Klok100/Automatic-Guitar-Tuner/ECE 445 Linear Regulator Analysis.pdf

3.3 Voltage regulator - LM2937-3.3

Part | Worst Case Current Draw @ 3.3 V | Comment
Processor | 140 mA | Total output current sunk by all I/O and Control Pins
LED (2) | 15 mA (30 mA total) | Assuming 100% on rate, based on resistor and LED voltage drop values
Total | 170 mA

LP2950CZ

Variable | Value | Comment
max(Ti) | 125 C | Maximum operating junction temperature
iout | 170 mA | Maximum current draw of 3.3 V components
vin | 9.6 V | Maximum voltage of a 9 V battery
vout | 3.3 V | Operating voltage of components
Θ ja | 65 C/W | Thermal resistance of junction to ambient per datasheet
Ta | 38 C | Hot day

T

j = i
out

(v

in − v
out

)(Θ) + T
a

≈ 108 C < max(T
i

)

5V Voltage regulator μA7805

Part | Worst Case Current Draw @ 5 V | Comment
L298N H Bridge (3) | 70 mA (210 mA total) | Max assuming: Ven = H; Vi = H; IL= 0
GA12-N20 Motors (6) | 30 mA (180 mA total) | Current consumed under load at 500 rpm
Total | 390 mA

μA7805

Variable | Value | Comment
max(Ti) | 150 C | Maximum operating junction temperature
iout | 390 mA | Max current draw of 5 V components
vin | 9.6 V | Maximum voltage of 9 V battery
vout | 5 V | Operating voltage of components
Θ ja | 19 C/W | Thermal resistance of junction to ambient per datasheet
Ta | 38 C | Hot Day

T

j = i
out

(v

in − v
out

)(Θ
jc

) + T
a

≈ 72 ℃ < max(T
i

)
