Klok100/Automatic-Guitar-Tuner/ECE 445 Senior-Design-Parts.md

# Senior Design Parts
## Power Subsystem:
#### Battery: 9V 
#### 3.3 Voltage Regulator: ~~AP2112K-3.3TRG1 (Electronics Service Shop)~~
LM2937-3.3 ([Digikey](https://www.digikey.com/en/products/detail/texas-instruments/LM2937ET-3-3-NOPB/363870)) ([Datasheet](https://rocelec.widen.net/view/pdf/oggg0ilb2c/NATLS20760-1.pdf?t.download=true&u=5oefqw])) TO-220 package  
#### 5 Voltage Regulator: ~~TPS7A2050PDBVR (Electronics Service Shop)~~
$\mu \text{A7805}$  ([Digikey](https://www.digikey.com/en/products/detail/texas-instruments/UA7805CKCS/521612))(~~[Mouser](https://www.mouser.com/ProductDetail/Texas-Instruments/UA7805CKCS?qs=IEl3ej0IqwDTl9fhEpiFdQ%3D%3D)~~) ([Datasheet](https://www.ti.com/lit/ds/symlink/ua78.pdf?ts=1740651676563&ref_url=https%253A%252F%252Fwww.google.com%252F)) TO-220 package (KCS)
## Motor Subsystem:
#### H-Bridge: L298N (Self-Service Inventory) ([Datasheet](https://www.st.com/resource/en/datasheet/l298.pdf)) (C11 D20)
#### Motors: GA12-N20 ([Amazon](https://www.amazon.com/dp/B07FYBQ7Z4?ref=ppx_yo2ov_dt_b_fed_asin_title))

## Processing Subsystem:
#### Microcontroller: STM32H7B0RBT6 ([Digikey](https://www.digikey.com/en/products/detail/stmicroelectronics/STM32H7B0RBT6/11591017)) ([Datasheet](https://www.st.com/resource/en/datasheet/stm32h7b0rb.pdf))

## Vibration Subsystem:
#### Piezo Disc Transducer: TXJ-055-US ([Amazon](https://www.amazon.com/dp/B077YJ3H6R?ref=ppx_yo2ov_dt_b_fed_asin_title))
#### Signal Amplifier: LM386N-1 ([Mouser](https://www.mouser.com/ProductDetail/Texas-Instruments/LM386N-1-NOPB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)) ([Datasheet](https://www.ti.com/lit/ds/symlink/lm386.pdf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)) (C12 D19)
#### Zener Diode: 1N4733A ([Digikey](https://www.digikey.com/en/products/detail/onsemi/1N4733A/977210)) ([Datasheet](https://rocelec.widen.net/view/pdf/7qfz7dzkx8/ONSM-S-A0003585147-1.pdf?t.download=true&u=5oefqw))
