Klok100/Automatic-Guitar-Tuner/3D_print/motor-dowel.stl

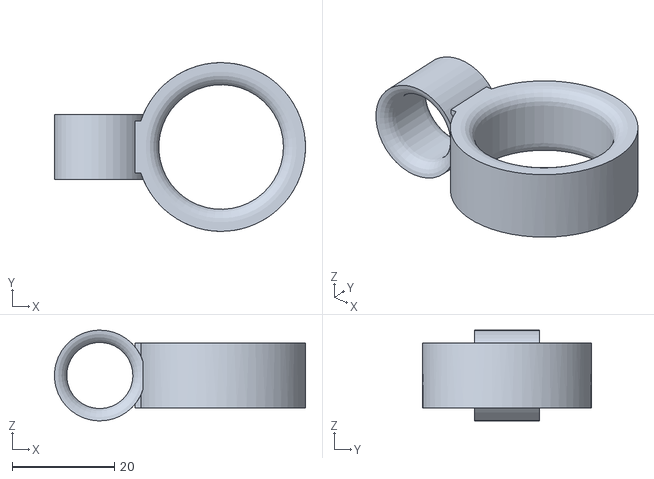
[picture p5: CAD file, 2025-05-09]
3D_print/motor-dowel.stl
49.1 x 33.0 x 17.8
