Klok100/Automatic-Guitar-Tuner/3D_print/PCB_mount.3mf

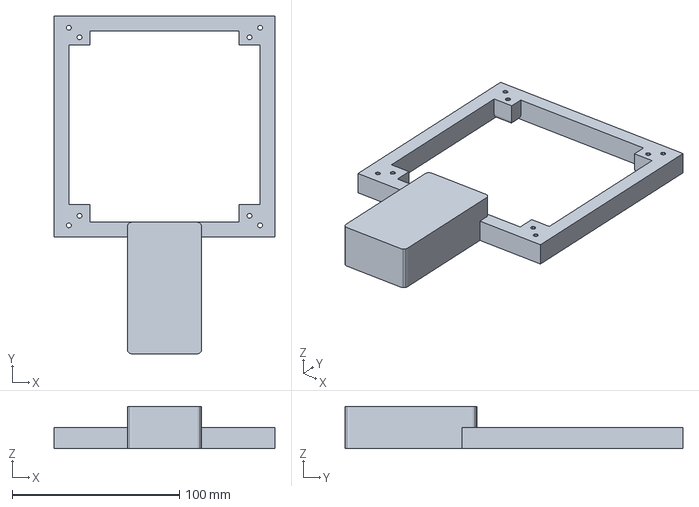
[picture p6: CAD file, 2025-05-09]
3D_print/PCB_mount.3mf
132.1 x 201.9 x 25.4 mm
