Klok100/Automatic-Guitar-Tuner/3D_print/plug.3mf

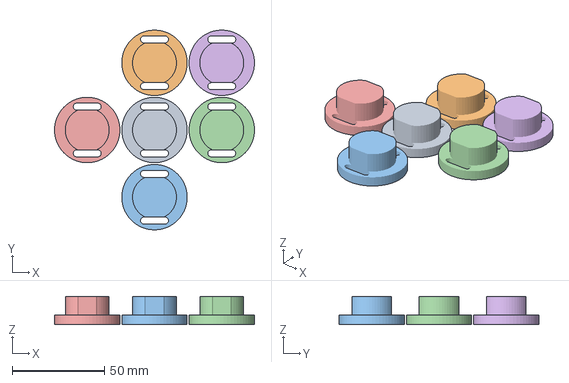
[picture p7: CAD file, 2025-05-09]
3D_print/plug.3mf
108.7 x 108.5 x 15.2 mm
plug.stl x 6
