Klok100/Automatic-Guitar-Tuner/3D_print/dowel-dowel.3mf

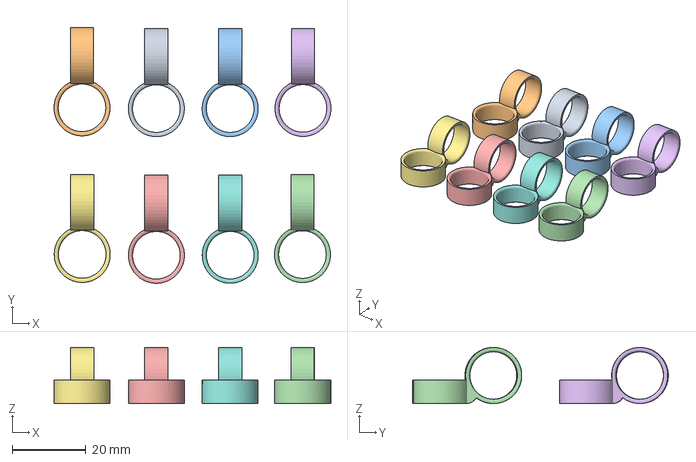
[picture p8: CAD file, 2025-05-09]
3D_print/dowel-dowel.3mf
75.3 x 69.5 x 15.2 mm
dowel-dowel.stl x 8
