Klok100/Automatic-Guitar-Tuner/3D_print/motor-tuningpeg-worm.stl

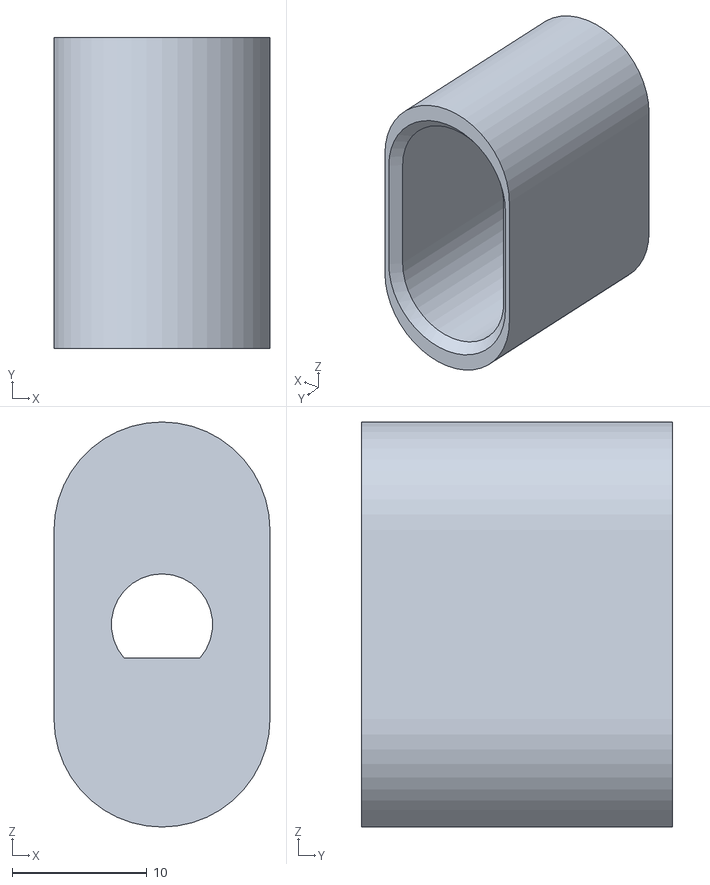
[picture p9: CAD file, 2025-05-09]
3D_print/motor-tuningpeg-worm.stl
16.0 x 23.0 x 30.0
