Klok100/Automatic-Guitar-Tuner/3D_print/magnet_mount_short.stl

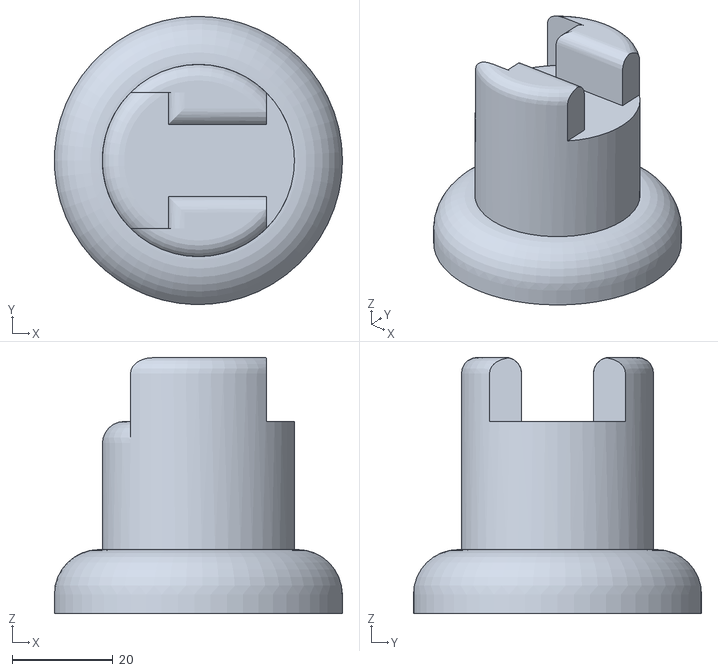
[picture p10: CAD file, 2025-04-02]
3D_print/magnet_mount_short.stl
57.1 x 57.1 x 50.8
