Klok100/Automatic-Guitar-Tuner/3D_print/magnet_mount.stl

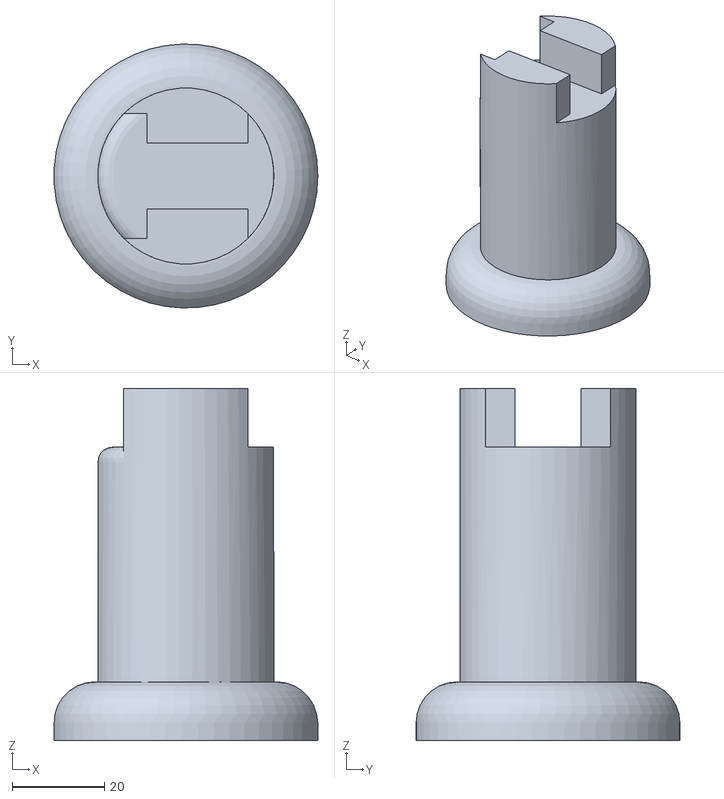
[picture p11: CAD file, 2025-04-02]
3D_print/magnet_mount.stl
57.1 x 57.1 x 76.2
