Klok100/Automatic-Guitar-Tuner/3D_print/motor-tuningpeg-mini.stl

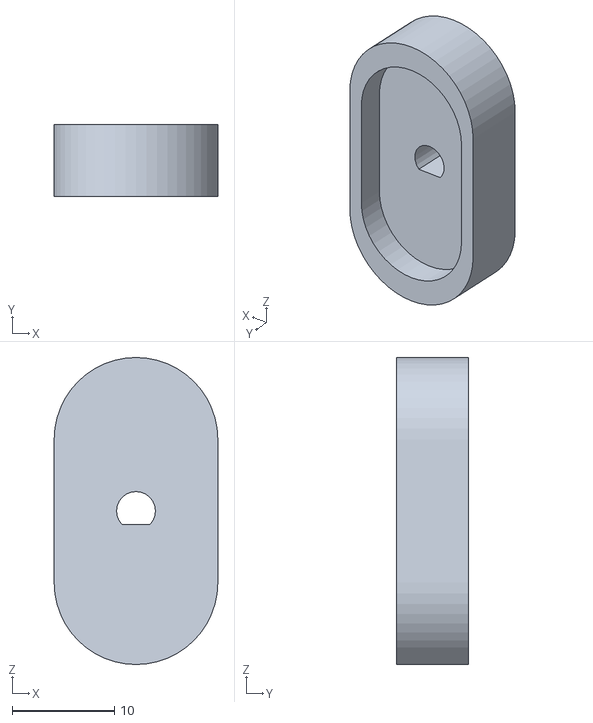
[picture p12: CAD file, 2025-03-06]
3D_print/motor-tuningpeg-mini.stl
16.0 x 7.00 x 30.0
