Klok100/Automatic-Guitar-Tuner/3D_print/N20shaft_sizing.stl

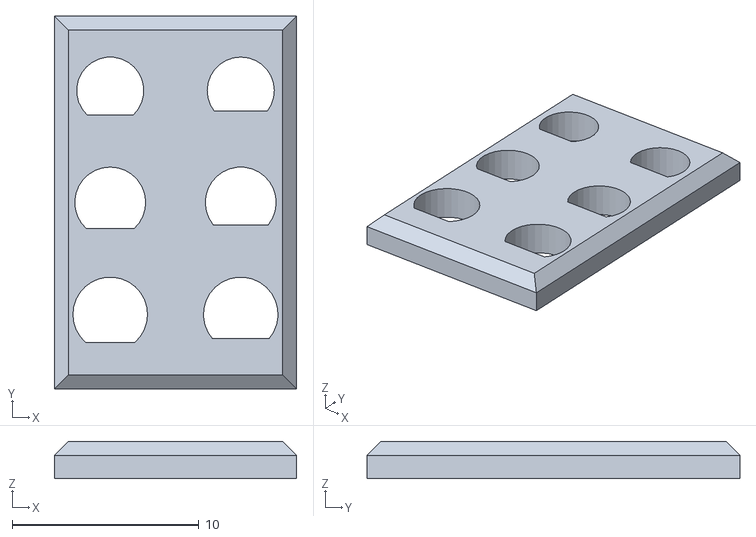
[picture p13: CAD file, 2025-03-06]
3D_print/N20shaft_sizing.stl
13.0 x 20.0 x 2.00
