Klok100/Automatic-Guitar-Tuner/(list of files, cad)

Other CAD files:
3D_print/PCB_mount.gcode.3mf
3D_print/plug.gcode.3mf
3D_print/dowel-dowel.gcode.3mf
3D_print/dowel-parts.gcode.3mf
3D_print/motor-tuningpeg.stl
3D_print/Battery.ipt
3D_print/Full_Model.iam
3D_print/Guitar.ipt
3D_print/N20shaft_sizing.ipt
3D_print/OldVersions/Battery.0001.ipt
3D_print/OldVersions/Full_Model.0013.iam
3D_print/OldVersions/Guitar.0003.ipt
3D_print/OldVersions/N20shaft_sizing.0002.ipt
3D_print/OldVersions/PCB.0003.ipt
3D_print/OldVersions/PCB_mount.0005.ipt
3D_print/OldVersions/dowel-dowel.0002.ipt
3D_print/OldVersions/half_inch_dowel_5inch.0001.ipt
3D_print/OldVersions/magnet_mount.0003.ipt
3D_print/OldVersions/motor-dowel.0002.ipt
3D_print/OldVersions/motor-tuningpeg-mini.0001.ipt
3D_print/OldVersions/motor-tuningpeg.0008.ipt
3D_print/OldVersions/plug.0001.ipt
3D_print/OldVersions/tuningpeg.0001.ipt
3D_print/PCB.ipt
3D_print/PCB_mount.ipt
3D_print/PCB_mount.stl
3D_print/dowel-dowel.ipt
3D_print/dowel-dowel.stl
3D_print/half_inch_dowel_10inch.ipt
3D_print/half_inch_dowel_5inch.ipt
3D_print/magnet_mount.ipt
3D_print/motor-dowel.ipt
3D_print/motor-tuningpeg-mini.ipt
3D_print/motor-tuningpeg.ipt
3D_print/motor.ipt
3D_print/plug.ipt
3D_print/plug.stl
3D_print/tuningpeg.ipt
