Klok100/Automatic-Guitar-Tuner/Senior_Design_PCB_ethanl7_nrkim2/Senior_Design_PCB_ethanl7_nrkim2.kicad_pcb

## KiCad design Senior_Design_PCB_ethanl7_nrkim2/Senior_Design_PCB_ethanl7_nrkim2.kicad_pcb (2025-05-09)

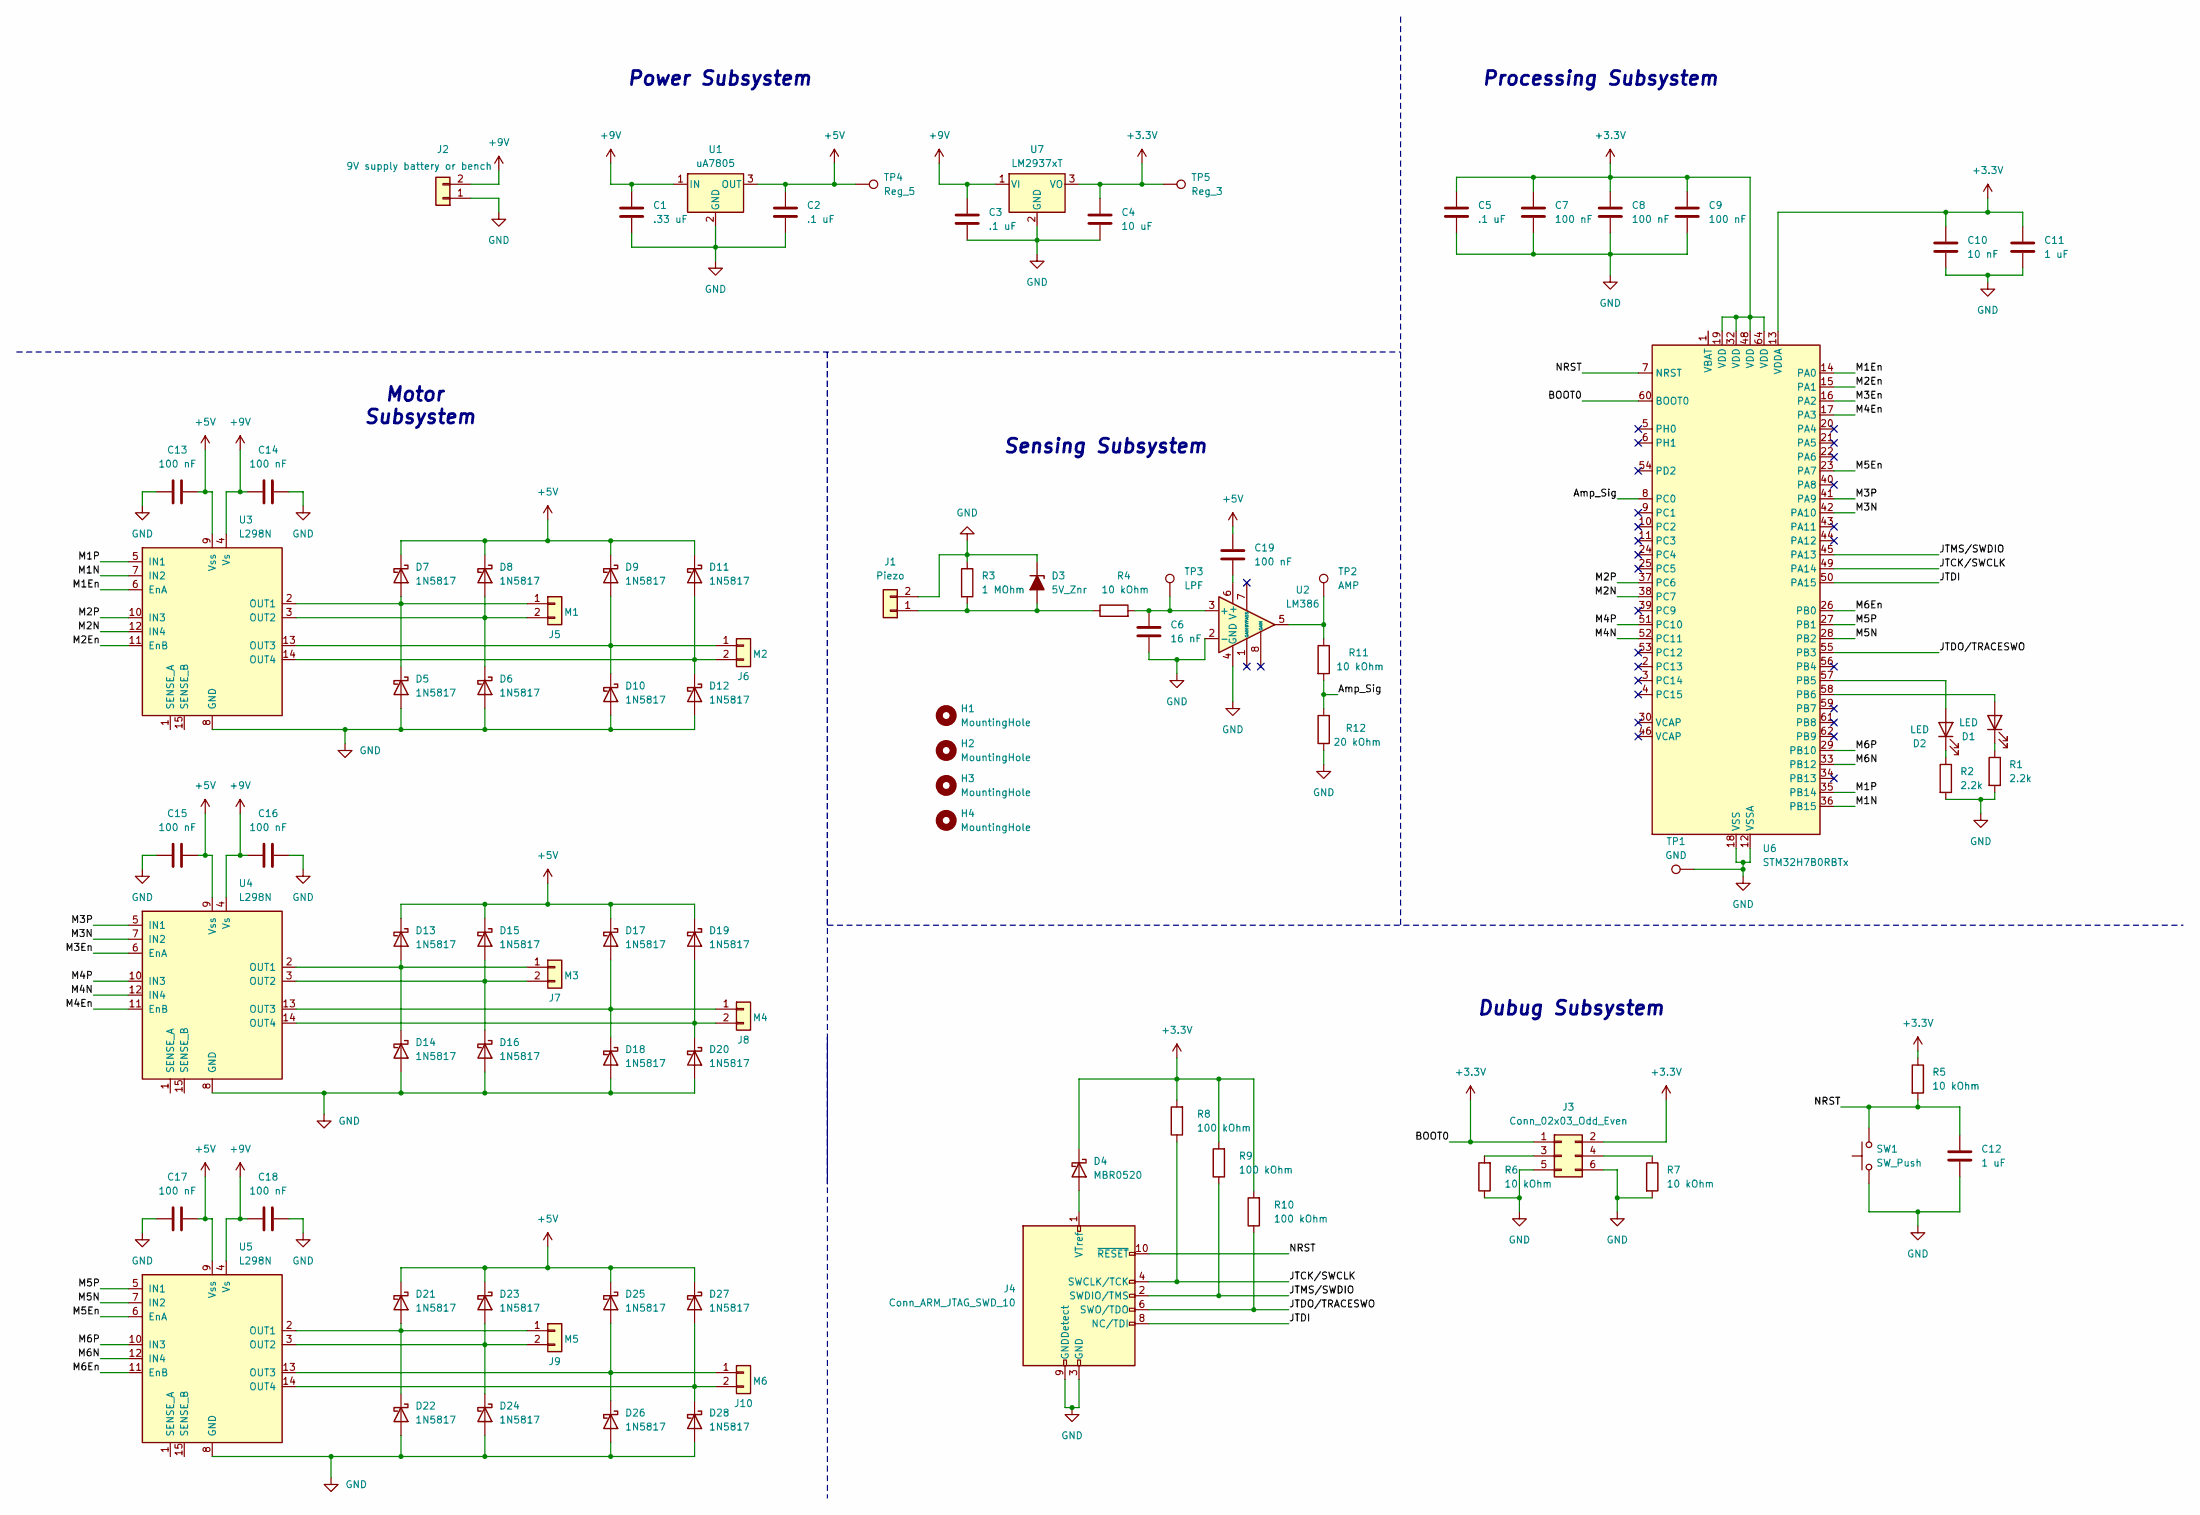
[picture p14: schematic Senior_Design_PCB_ethanl7_nrkim2.kicad_sch, Automatic Guitar Tuner]

Parts:
C1: .33 uF; C_0805_2012Metric_Pad1.18x1.45mm_HandSolder
C2, C3, C5: .1 uF; C_0805_2012Metric_Pad1.18x1.45mm_HandSolder
C4: 10 uF; C_0805_2012Metric_Pad1.18x1.45mm_HandSolder
C6: 16 nF; C_0805_2012Metric_Pad1.18x1.45mm_HandSolder
C7, C8, C9, C13, C14, C15, C16, C17, C18, C19: 100 nF; C_0805_2012Metric_Pad1.18x1.45mm_HandSolder
C10: 10 nF; C_0805_2012Metric_Pad1.18x1.45mm_HandSolder
C11, C12: 1 uF; C_0805_2012Metric_Pad1.18x1.45mm_HandSolder
D1, D2: LED; Molex_KK-254_AE-6410-02A_1x02_P2.54mm_Vertical
D3: 5V_Znr; D_DO-41_SOD81_P10.16mm_Horizontal
D4: MBR0520; D_SOD-123
D5, D6, D7, D8, D9, D10, D11, D12, D13, D14, D15, D16, D17, D18, D19, D20, D21, D22, D23, D24, D25, D26, D27, D28: 1N5817; D_DO-41_SOD81_P10.16mm_Horizontal
H1, H2, H3, H4: MountingHole; MountingHole_3.2mm_M3
J1: Piezo; Molex_KK-254_AE-6410-02A_1x02_P2.54mm_Vertical
J2: 9V supply battery or bench; Molex_KK-254_AE-6410-02A_1x02_P2.54mm_Vertical
J3: Conn_02x03_Odd_Even; PinSocket_2x03_P2.54mm_Vertical
J4: Conn_ARM_JTAG_SWD_10; IDC-Header_2x05_P2.54mm_Vertical
J5: M1; Molex_KK-254_AE-6410-02A_1x02_P2.54mm_Vertical
J6: M2; Molex_KK-254_AE-6410-02A_1x02_P2.54mm_Vertical
J7: M3; Molex_KK-254_AE-6410-02A_1x02_P2.54mm_Vertical
J8: M4; Molex_KK-254_AE-6410-02A_1x02_P2.54mm_Vertical
J9: M5; Molex_KK-254_AE-6410-02A_1x02_P2.54mm_Vertical
J10: M6; Molex_KK-254_AE-6410-02A_1x02_P2.54mm_Vertical
R1, R2: 2.2k; R_0805_2012Metric_Pad1.20x1.40mm_HandSolder
R3: 1 MOhm; R_0805_2012Metric_Pad1.20x1.40mm_HandSolder
R4, R5, R6, R7, R11: 10 kOhm; R_0805_2012Metric_Pad1.20x1.40mm_HandSolder
R8, R9, R10: 100 kOhm; R_0805_2012Metric_Pad1.20x1.40mm_HandSolder
R12: 20 kOhm; R_0805_2012Metric_Pad1.20x1.40mm_HandSolder
SW1: SW_Push; SW_SPST_B3S-1000
TP1: GND; TestPoint_Pad_D1.5mm
TP2: AMP; TestPoint_Pad_D1.5mm
TP3: LPF; TestPoint_Pad_D1.5mm
TP4: Reg_5; TestPoint_Pad_D1.5mm
TP5: Reg_3; TestPoint_Pad_D1.5mm
U1: uA7805; TO-220-3_Vertical
U2: LM386; DIP-8_W7.62mm
U3, U4, U5: L298N; TO-220-15_P2.54x2.54mm_StaggerOdd_Lead4.58mm_Vertical
U6: STM32H7B0RBTx; LQFP-64_10x10mm_P0.5mm
U7: LM2937xT; TO-220-3_Vertical

Connections:
+3.3V: C4.1, C5.1, C7.1, C8.1, C9.1, C10.1, C11.1, D4.1 (K), J3.1, J3.2, R5.1, R8.2, R9.2, R10.2, TP5.1, U6.13 (VDDA), U6.19 (VDD), U6.32 (VDD), U6.48 (VDD), U6.60 (BOOT0), U6.64 (VDD), U7.3 (VO)
+5V: C2.1, C13.2, C15.2, C17.2, C19.2, D7.1 (K), D8.1 (K), D9.1 (K), D11.1 (K), D13.1 (K), D15.1 (K), D17.1 (K), D19.1 (K), D21.1 (K), D23.1 (K), D25.1 (K), D27.1 (K), TP4.1, U1.3 (OUT), U3.9 (Vss), U4.9 (Vss), U5.9 (Vss)
+9V: C1.1, C3.1, C14.1, C16.1, C18.1, J2.2, U1.1 (IN), U3.4 (Vs), U4.4 (Vs), U5.4 (Vs), U7.1 (VI)
/Amp_Sig: R11.2, R12.2, U6.8 (PC0)
/JTCK/SWCLK: J4.4 (SWCLK/TCK), R8.1, U6.49 (PA14)
/JTDI: J4.8 (NC/TDI), U6.50 (PA15)
/JTDO/TRACESWO: J4.6 (SWO/TDO), R10.1, U6.55 (PB3)
/JTMS/SWDIO: J4.2 (SWDIO/TMS), R9.1, U6.45 (PA13)
/M1En: U3.6 (EnA), U6.14 (PA0)
/M1N: U3.7 (IN2), U6.36 (PB15)
/M1P: U3.5 (IN1), U6.35 (PB14)
/M2En: U3.11 (EnB), U6.15 (PA1)
/M2N: U3.12 (IN4), U6.38 (PC7)
/M2P: U3.10 (IN3), U6.37 (PC6)
/M3En: U4.6 (EnA), U6.16 (PA2)
/M3N: U4.7 (IN2), U6.42 (PA10)
/M3P: U4.5 (IN1), U6.41 (PA9)
/M4En: U4.11 (EnB), U6.17 (PA3)
/M4N: U4.12 (IN4), U6.52 (PC11)
/M4P: U4.10 (IN3), U6.51 (PC10)
/M5En: U5.6 (EnA), U6.23 (PA7)
/M5N: U5.7 (IN2), U6.28 (PB2)
/M5P: U5.5 (IN1), U6.27 (PB1)
/M6En: U5.11 (EnB), U6.26 (PB0)
/M6N: U5.12 (IN4), U6.33 (PB12)
/M6P: U5.10 (IN3), U6.29 (PB10)
/NRST: C12.1, J4.10 (~RESET), R5.2, SW1.2, U6.7 (NRST)
GND: C1.2, C2.2, C3.2, C4.2, C5.2, C6.1, C7.2, C8.2, C9.2, C10.2, C11.2, C12.2, C13.1, C14.2, C15.1, C16.2, C17.1, C18.2, D3.1 (K), D5.2 (A), D6.2 (A), D10.2 (A), D12.2 (A), D14.2 (A), D16.2 (A), D18.2 (A), D20.2 (A), D22.2 (A), D24.2 (A), D26.2 (A), D28.2 (A), J1.2, J2.1, J3.5, J3.6, J4.3 (GND), J4.5 (GND), J4.9 (GNDDetect), R1.2, R2.2, R3.1, R6.1, R7.2, R12.1, SW1.1, TP1.1, U1.2 (GND), U2.2 (-), U2.4 (GND), U3.8 (GND), U4.8 (GND), U5.8 (GND), U6.12 (VSSA), U6.18 (VSS), U6.31 (VSS), U6.47 (VSS), U6.63 (VSS), U7.2 (GND)
unnamed: D1.2 (A), U6.58 (PB6)
unnamed: D1.1 (K), R1.1
unnamed: D2.2 (A), U6.57 (PB5)
unnamed: D2.1 (K), R2.1
unnamed: D3.2 (A), J1.1, R3.2, R4.1
unnamed: D4.2 (A), J4.1 (VTref)
unnamed: D5.1 (K), D7.2 (A), J5.1, U3.2 (OUT1)
unnamed: D6.1 (K), D8.2 (A), J5.2, U3.3 (OUT2)
unnamed: D9.2 (A), D10.1 (K), J6.1, U3.13 (OUT3)
unnamed: D11.2 (A), D12.1 (K), J6.2, U3.14 (OUT4)
unnamed: D13.2 (A), D14.1 (K), J7.1, U4.2 (OUT1)
unnamed: D15.2 (A), D16.1 (K), J7.2, U4.3 (OUT2)
unnamed: D17.2 (A), D18.1 (K), J8.1, U4.13 (OUT3)
unnamed: D19.2 (A), D20.1 (K), J8.2, U4.14 (OUT4)
unnamed: D21.2 (A), D22.1 (K), J9.1, U5.2 (OUT1)
unnamed: D23.2 (A), D24.1 (K), J9.2, U5.3 (OUT2)
unnamed: D25.2 (A), D26.1 (K), J10.1, U5.13 (OUT3)
unnamed: D27.2 (A), D28.1 (K), J10.2, U5.14 (OUT4)
unnamed: J3.3, R6.2
unnamed: J3.4, R7.1
unnamed: R11.1, TP2.1, U2.5
unnamed: C6.2, R4.2, TP3.1, U2.3 (+)
unnamed: C19.1, U2.6 (V+)

Notes on the sheet:
Power Subsystem
Processing Subsystem
Sensing Subsystem
Dubug Subsystem
Motor Subsystem

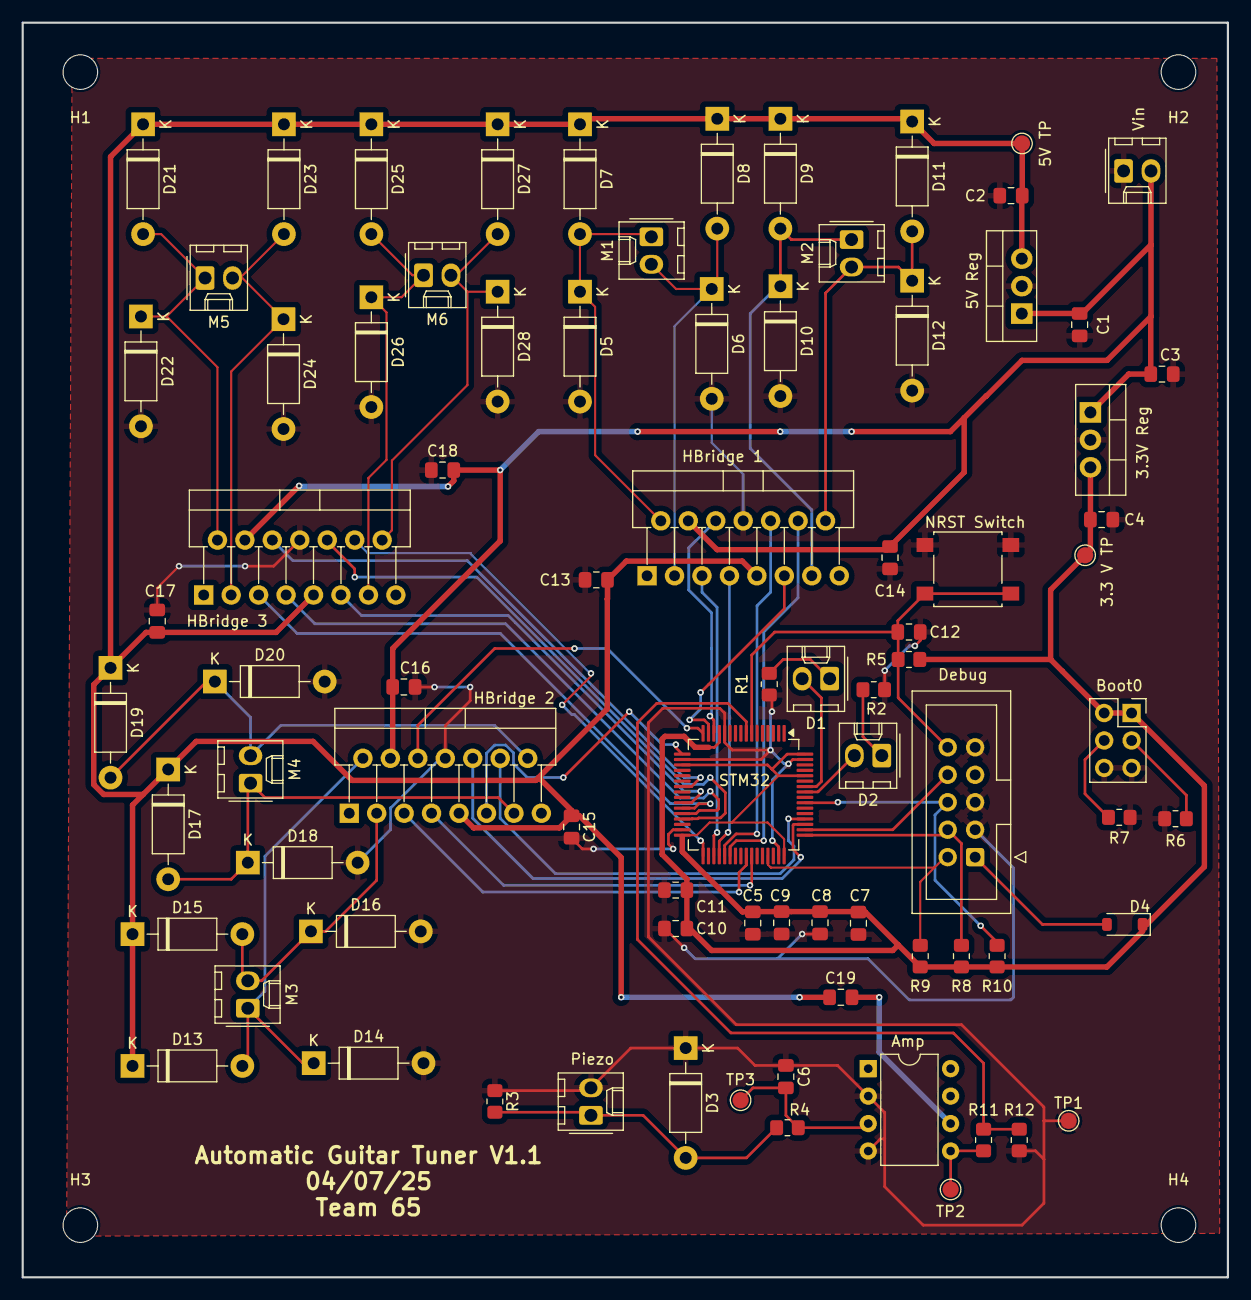
[picture p15: board Senior_Design_PCB_ethanl7_nrkim2.kicad_pcb from above]

Board: 2 copper layers, 111.5 x 116.1 mm, 86 parts (0 on the bottom side), 51 nets.
