Klok100/Automatic-Guitar-Tuner/Microcontroller Code/FFT_Testing/FFT_Testing.ioc

Mcu.UserName=STM32H753ZITx
PB0.GPIO_Label=Green_LED
PB0.Signal=GPIO_Output
PB14.GPIO_Label=Red_LED
PB14.Signal=GPIO_Output
PD8.Signal=USART3_TX
PD9.Signal=USART3_RX
PE0.GPIO_Label=Sampling_Rate
PE0.Signal=GPIO_Output
PE1.GPIO_Label=Yellow_LED
PE1.Signal=GPIO_Output
PE14.GPIO_Label=Motor_Control_2
PE14.Signal=GPIO_Output
PF3.GPIO_Label=Motor_Enable
PF3.Signal=GPIO_Output
PF5.Signal=ADC3_INP4
PF6.Signal=ADC3_INN4
PG14.GPIO_Label=Motor_Control_1
PG14.Signal=GPIO_Output
