Klok100/Automatic-Guitar-Tuner/Microcontroller Code/FFT_Testing/Core/Inc/main.h

#define Motor_Enable_Pin GPIO_PIN_3
#define Motor_Enable_GPIO_Port GPIOF
#define Green_LED_Pin GPIO_PIN_0
#define Green_LED_GPIO_Port GPIOB
#define Motor_Control_2_Pin GPIO_PIN_14
#define Motor_Control_2_GPIO_Port GPIOE
#define Red_LED_Pin GPIO_PIN_14
#define Red_LED_GPIO_Port GPIOB
#define Motor_Control_1_Pin GPIO_PIN_14
#define Motor_Control_1_GPIO_Port GPIOG
#define Sampling_Rate_Pin GPIO_PIN_0
#define Sampling_Rate_GPIO_Port GPIOE
#define Yellow_LED_Pin GPIO_PIN_1
#define Yellow_LED_GPIO_Port GPIOE
