Klok100/Automatic-Guitar-Tuner/(commit log)

2025-02-27 Update 3.3 Voltage Regulator
2025-02-27 Added 5V Regulator
2025-02-28 Added KiCad Files
    [Senior_Design_PCB_ethanl7_nrkim2.kicad_pcb, Senior_Design_PCB_ethanl7_nrkim2.kicad_sch]
2025-02-28 Update Senior-Design-Parts.md
    Update parts with datasheets and links according to new needs during schematic design process
2025-02-28 added linear regulator analysis, editable doc in GDrive
2025-02-28 changes to schematic
    [Senior_Design_PCB_ethanl7_nrkim2.kicad_sch]
2025-02-28 add backing files for schematic
2025-02-28 schematic power supply and sensing
    [Senior_Design_PCB_ethanl7_nrkim2.kicad_sch]
2025-03-04 Update Ethan-Lab-Notebook.md
    added 3d printing info
2025-03-05 added 3d printing files
    [motor-tuningpeg.ipt, motor-tuningpeg.stl]
2025-03-06 increased part sizes of 3d print files
    [motor-tuningpeg.0002.ipt, motor-tuningpeg.ipt]
2025-03-06 motor shaft sizing 3d print file
    [N20shaft_sizing.0001.ipt, N20shaft_sizing.ipt]
2025-03-06 added stl for shaft sizing part
    [N20shaft_sizing.stl]
2025-03-06 new shaft sizing on main part and new mini part for testing
    [N20shaft_sizing.0001.ipt, N20shaft_sizing.0002.ipt, N20shaft_sizing.ipt, motor-tuningpeg-mini.0001.ipt, motor-tuningpeg-mini.ipt, motor-tuningpeg-mini.stl, motor-tuningpeg.0002.ipt, motor-tuningpeg.0003.ipt]
2025-03-06 adjust tuning peg to motor connection
    [motor-tuningpeg.0003.ipt, motor-tuningpeg.0004.ipt, motor-tuningpeg.ipt, motor-tuningpeg.stl]
2025-03-11 scopy spectrogram data, slight updates to magnet mount and PCB schematic
    [A.csv, B.csv, D.csv, G.csv, HighE.csv, LowE.csv, Senior_Design_PCB_ethanl7_nrkim2.kicad_sch, Strum.csv]
2025-03-11 out of tune spectrogram added
    [outoftune.csv]
2025-03-11 magnet mount stl
    [magnet_mount.stl]
2025-03-18 schematic updates
    [Senior_Design_PCB_ethanl7_nrkim2.kicad_sch]
2025-03-18 added fillet to base of magnet mount
    [magnet_mount.0001.ipt, magnet_mount.ipt, magnet_mount.stl]
2025-03-27 made mgnet mount shorter
    [magnet_mount.0001.ipt, magnet_mount.0002.ipt, magnet_mount.ipt, magnet_mount_short.stl]
2025-03-30 finished schematic, started pcb
    [Senior_Design_PCB_ethanl7_nrkim2.kicad_pcb, Senior_Design_PCB_ethanl7_nrkim2.kicad_sch]
2025-04-02 finished v1 pcb design
    [Senior_Design_PCB_ethanl7_nrkim2-B_Cu.gbr, Senior_Design_PCB_ethanl7_nrkim2-B_Mask.gbr, Senior_Design_PCB_ethanl7_nrkim2-B_Paste.gbr, Senior_Design_PCB_ethanl7_nrkim2-B_Silkscreen.gbr, Senior_Design_PCB_ethanl7_nrkim2-Edge_Cuts.gbr, Senior_Design_PCB_ethanl7_nrkim2-F_Cu.gbr, Senior_Design_PCB_ethanl7_nrkim2-F_Mask.gbr, Senior_Design_PCB_ethanl7_nrkim2-F_Paste.gbr]
2025-04-02 added out of tune scopy and dims on part files
    [LowE.csv, Strum.csv, magnet_mount.0002.ipt, magnet_mount.0003.ipt, magnet_mount.ipt, motor-tuningpeg.0004.ipt, motor-tuningpeg.0005.ipt, motor-tuningpeg.ipt]
2025-04-03 tweaked PCB layout
    [Senior_Design_PCB_ethanl7_nrkim2.kicad_pcb]
2025-04-08 V1.1 pcb
    [Senior_Design_PCB_ethanl7_nrkim2-B_Cu.gbr, Senior_Design_PCB_ethanl7_nrkim2-B_Mask.gbr, Senior_Design_PCB_ethanl7_nrkim2-B_Paste.gbr, Senior_Design_PCB_ethanl7_nrkim2-B_Silkscreen.gbr, Senior_Design_PCB_ethanl7_nrkim2-Edge_Cuts.gbr, Senior_Design_PCB_ethanl7_nrkim2-F_Cu.gbr, Senior_Design_PCB_ethanl7_nrkim2-F_Mask.gbr, Senior_Design_PCB_ethanl7_nrkim2-F_Paste.gbr]
2025-04-14 PCB updates, new motor tuning peg for worm motor, new motor part file for 3d modeling purposes
    [motor-tuningpeg-worm.stl, motor-tuningpeg.0005.ipt, motor-tuningpeg.0007.ipt, motor-tuningpeg.ipt, motor.ipt]
2025-04-15 enlarged tuning peg hole by 1mm, created assembly and parts for full 3d model
    [Full_Model.0001.iam, Full_Model.iam, half_inch_dowel_5inch.ipt, motor-tuningpeg-worm.stl, motor-tuningpeg.0007.ipt, motor-tuningpeg.0008.ipt, motor-tuningpeg.ipt]
2025-04-16 created guitar 3d model for full 3d model, started assembly of full 3d model
    [Full_Model.0001.iam, Full_Model.0002.iam, Full_Model.iam, Guitar.0003.ipt, Guitar.ipt]
2025-04-17 more 3d model parts and updated assembly
    [Full_Model.0002.iam, Full_Model.0005.iam, Full_Model.iam, motor-dowel.ipt, tuningpeg.0001.ipt, tuningpeg.ipt]
2025-04-19 added more 3d model parts
    [Battery.0001.ipt, Battery.ipt, Full_Model.0005.iam, Full_Model.0012.iam, Full_Model.iam, PCB.0003.ipt, PCB.ipt, PCB_mount.0004.ipt]
2025-04-21 stl files for 3d printing
    [PCB_mount.3mf, PCB_mount.gcode.3mf, PCB_mount.stl, dowel-dowel.3mf, dowel-dowel.stl, dowel-parts.gcode.3mf, motor-dowel.stl]
2025-05-08 PCB and 3D printed final parts and version
    [Full_Model.0012.iam, Full_Model.0013.iam, Full_Model.iam, PCB_mount.0004.ipt, PCB_mount.0005.ipt, PCB_mount.ipt, dowel-dowel.0002.ipt, dowel-dowel.3mf]
2025-05-08 pcb no changes
2025-05-09 Commit files for merge
    [LowE.csv, LowE_OOT.csv, Strum.csv, Strum_OOT.csv, outoftune.csv]
