Klok100/Automatic-Guitar-Tuner/(notices)

Notices in the files:
Microcontroller Code/FFT_Testing/Core/Inc/main.h:
Copyright (c) 2025 STMicroelectronics.
All rights reserved.
This software is licensed under terms that can be found in the LICENSE file
